bzeiss/roland-mram-card/mram-card/d50mram.kicad_pcb

## KiCad design mram-card/d50mram.kicad_pcb (2024-01-06)

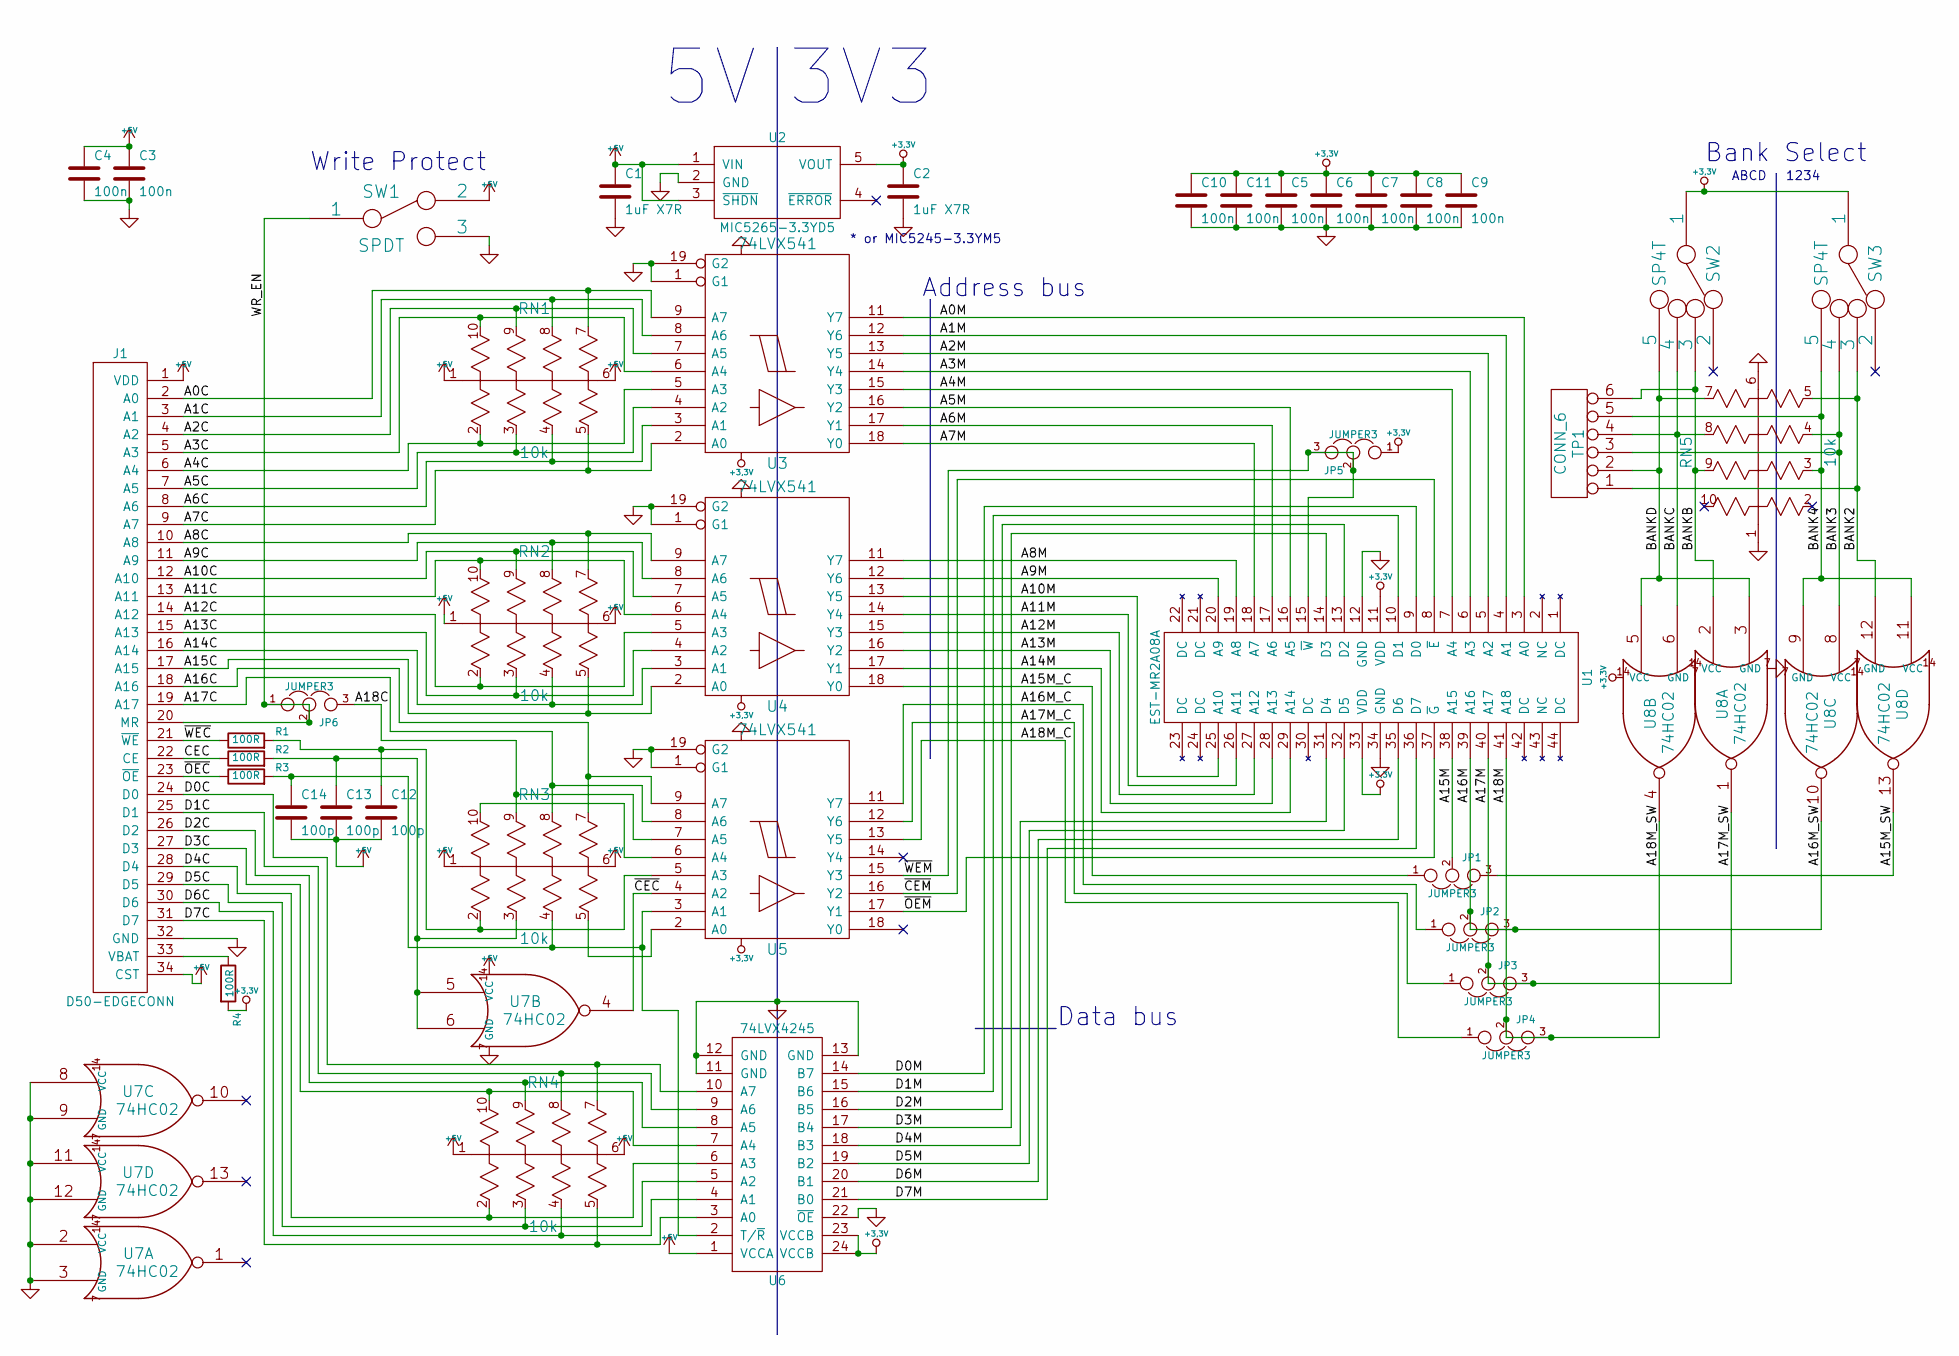
[picture p1: schematic d50mram.kicad_sch]

Parts:
C1, C2: 1uF X7R; C_0603_1608Metric
C3, C4, C5, C6, C7, C8, C9, C10, C11: 100n; C_0603_1608Metric
C12, C13, C14: 100p; C_0603_1608Metric
J1: D50-EDGECONN; EDGE1S34
JP1, JP2, JP3, JP4, JP5, JP6: JUMPER3; S_JUMPER_3
R1, R2, R3, R4: 100R; R_0603_1608Metric
RN1, RN2, RN3, RN4, RN5: 10k; CAT25; Digikey U8103CT-ND
SW1: SPDT; CUS-12B; Digikey 563-1102-1-ND
SW2, SW3: SP4T; CUS-14B; Digikey 563-1104-1-ND
TP1: CONN_6; 6P_TESTPT
U1: EST-MR2A08A; TSOP2-44; Digikey 819-1004-ND
U2: MIC5265-3.3YD5; SOT23-5; Digikey 576-2835-1-ND
U3, U4, U5: 74LVX541; tssop-20; Digikey 74LVX541MTCXCT-ND
U6: 74LVX4245; tssop-24; Digikey 74LVX4245MTCXCT-ND
U7, U8: 74HC02; tssop-14; Digikey MM74HC02MTCXCT-ND

Connections:
+3.3V: C2.1, C5.1, C6.1, C7.1, C8.1, C9.1, C10.1, C11.1, JP5.1, R4.2, SW2.1, SW3.1, U1.11 (VDD), U1.33 (VDD), U2.5 (VOUT), U3.20 (VCC), U4.20 (VCC), U5.20 (VCC), U6.23 (VCCB), U6.24 (VCCB), U8.14 (VCC)
+5V: C1.1, C3.1, C4.1, C12.2, C13.2, C14.2, J1.1 (VDD), J1.34 (CST), RN1.1, RN1.6, RN2.1, RN2.6, RN3.1, RN3.6, RN4.1, RN4.6, SW1.2, U2.1 (VIN), U2.3 (~SHDN), U6.1 (VCCA), U7.14 (VCC)
/A0C: J1.2 (A0), RN1.7, U3.9 (A7)
/A0M: U1.3 (A0), U3.11 (Y7)
/A1C: J1.3 (A1), RN1.8, U3.8 (A6)
/A1M: U1.4 (A1), U3.12 (Y6)
/A2C: J1.4 (A2), RN1.9, U3.7 (A5)
/A2M: U1.5 (A2), U3.13 (Y5)
/A3C: J1.5 (A3), RN1.10, U3.6 (A4)
/A3M: U1.6 (A3), U3.14 (Y4)
/A4C: J1.6 (A4), RN1.2, U3.5 (A3)
/A4M: U1.7 (A4), U3.15 (Y3)
/A5C: J1.7 (A5), RN1.3, U3.4 (A2)
/A5M: U1.16 (A5), U3.16 (Y2)
/A6C: J1.8 (A6), RN1.4, U3.3 (A1)
/A6M: U1.17 (A6), U3.17 (Y1)
/A7C: J1.9 (A7), RN1.5, U3.2 (A0)
/A7M: U1.18 (A7), U3.18 (Y0)
/A8C: J1.10 (A8), RN2.7, U4.9 (A7)
/A8M: U1.19 (A8), U4.11 (Y7)
/A9C: J1.11 (A9), RN2.8, U4.8 (A6)
/A9M: U1.20 (A9), U4.12 (Y6)
/A10C: J1.12 (A10), RN2.9, U4.7 (A5)
/A10M: U1.25 (A10), U4.13 (Y5)
/A11C: J1.13 (A11), RN2.10, U4.6 (A4)
/A11M: U1.26 (A11), U4.14 (Y4)
/A12C: J1.14 (A12), RN2.2, U4.5 (A3)
/A12M: U1.27 (A12), U4.15 (Y3)
/A13C: J1.15 (A13), RN2.3, U4.4 (A2)
/A13M: U1.28 (A13), U4.16 (Y2)
/A14C: J1.16 (A14), RN2.4, U4.3 (A1)
/A14M: U1.29 (A14), U4.17 (Y1)
/A15C: J1.17 (A15), RN2.5, U4.2 (A0)
/A15M: JP1.2, U1.38 (A15)
/A15M_C: JP1.1, U4.18 (Y0)
/A15M_SW: JP1.3, U8.13
/A16C: J1.18 (A16), RN3.7, U5.9 (A7)
/A16M: JP2.2, JP2.3, U1.39 (A16), U8.10
/A16M_C: JP2.1, U5.11 (Y7)
/A17C: J1.19 (A17), RN3.8, U5.8 (A6)
/A17M: JP3.2, JP3.3, U1.40 (A17), U8.1
/A17M_C: JP3.1, U5.12 (Y6)
/A18C: JP6.3, RN3.9, U5.7 (A5)
/A18M: JP4.2, JP4.3, U1.41 (A18), U8.4
/A18M_C: JP4.1, U5.13 (Y5)
/BANK2: RN5.5, SW3.3, TP1.1, U8.12
/BANK3: RN5.4, SW3.4, TP1.3, U8.8
/BANK4: RN5.3, SW3.5, TP1.5, U8.9, U8.11
/BANKB: RN5.9, SW2.3, TP1.6, U8.2
/BANKC: RN5.8, SW2.4, TP1.4, U8.6
/BANKD: RN5.7, SW2.5, TP1.2, U8.3, U8.5
/CEC: J1.22 (CE), R2.1
/D0C: J1.24 (D0), RN4.7, U6.10 (A7)
/D0M: U1.9 (D0), U6.14 (B7)
/D1C: J1.25 (D1), RN4.8, U6.9 (A6)
/D1M: U1.10 (D1), U6.15 (B6)
/D2C: J1.26 (D2), RN4.9, U6.8 (A5)
/D2M: U1.13 (D2), U6.16 (B5)
/D3C: J1.27 (D3), RN4.10, U6.7 (A4)
/D3M: U1.14 (D3), U6.17 (B4)
/D4C: J1.28 (D4), RN4.2, U6.6 (A3)
/D4M: U1.31 (D4), U6.18 (B3)
/D5C: J1.29 (D5), RN4.3, U6.5 (A2)
/D5M: U1.32 (D5), U6.19 (B2)
/D6C: J1.30 (D6), RN4.4, U6.4 (A1)
/D6M: U1.35 (D6), U6.20 (B1)
/D7C: J1.31 (D7), RN4.5, U6.3 (A0)
/D7M: U1.36 (D7), U6.21 (B0)
/WR_EN: J1.20 (MR), JP6.1, JP6.2, SW1.1
/~CEC: U5.4 (A2), U7.4
/~CEM: U1.8 (~E), U5.16 (Y2)
/~OEC: J1.23 (~OE), R3.1
/~OEM: U1.37 (~G), U5.17 (Y1)
/~WEC: J1.21 (~WE), R1.1
/~WEM: JP5.2, JP5.3, U1.15 (~W), U5.15 (Y3)
GND: C1.2, C2.2, C3.2, C4.2, C5.2, C6.2, C7.2, C8.2, C9.2, C10.2, C11.2, J1.32 (GND), RN5.1, RN5.6, SW1.3, U1.12 (GND), U1.34 (GND), U2.2 (GND), U3.1 (G1), U3.10 (GND), U3.19 (G2), U4.1 (G1), U4.10 (GND), U4.19 (G2), U5.1 (G1), U5.10 (GND), U5.19 (G2), U6.11 (GND), U6.12 (GND), U6.13 (GND), U6.22 (~OE), U7.2, U7.3, U7.7 (GND), U7.8, U7.9, U7.11, U7.12, U8.7 (GND)
unnamed: C12.1, R1.2, RN3.2, U5.5 (A3)
unnamed: C13.1, R2.2, RN3.3, U7.5, U7.6
unnamed: C14.1, R3.2, RN3.4, U5.3 (A1), U6.2 (T/~R)
unnamed: J1.33 (VBAT), R4.1
unnamed: RN3.5, U5.2 (A0)
unnamed: RN3.10, U5.6 (A4)

Notes on the sheet:
Bank Select
Address bus
1234
ABCD
Data bus
Write Protect
3V3
* or MIC5245-3.3YM5

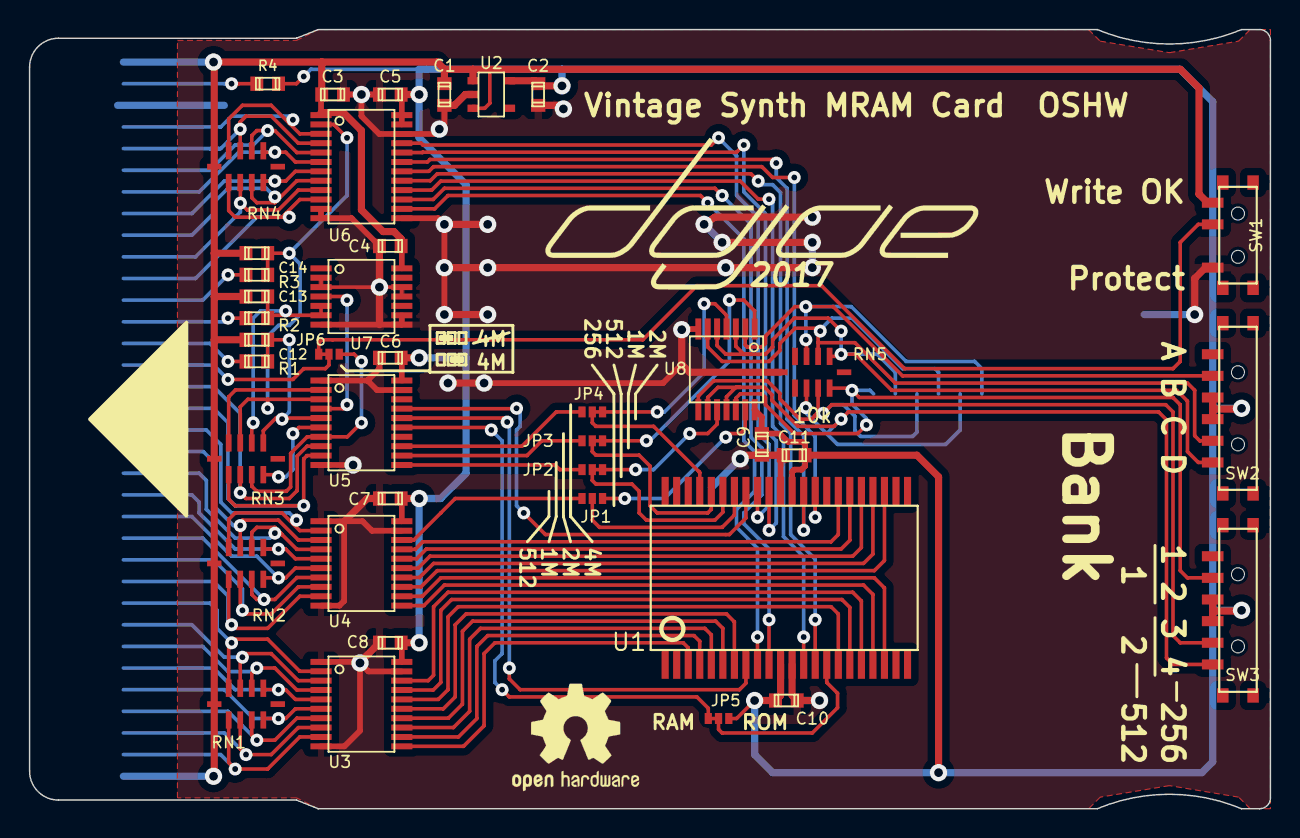
[picture p2: board d50mram.kicad_pcb from above]

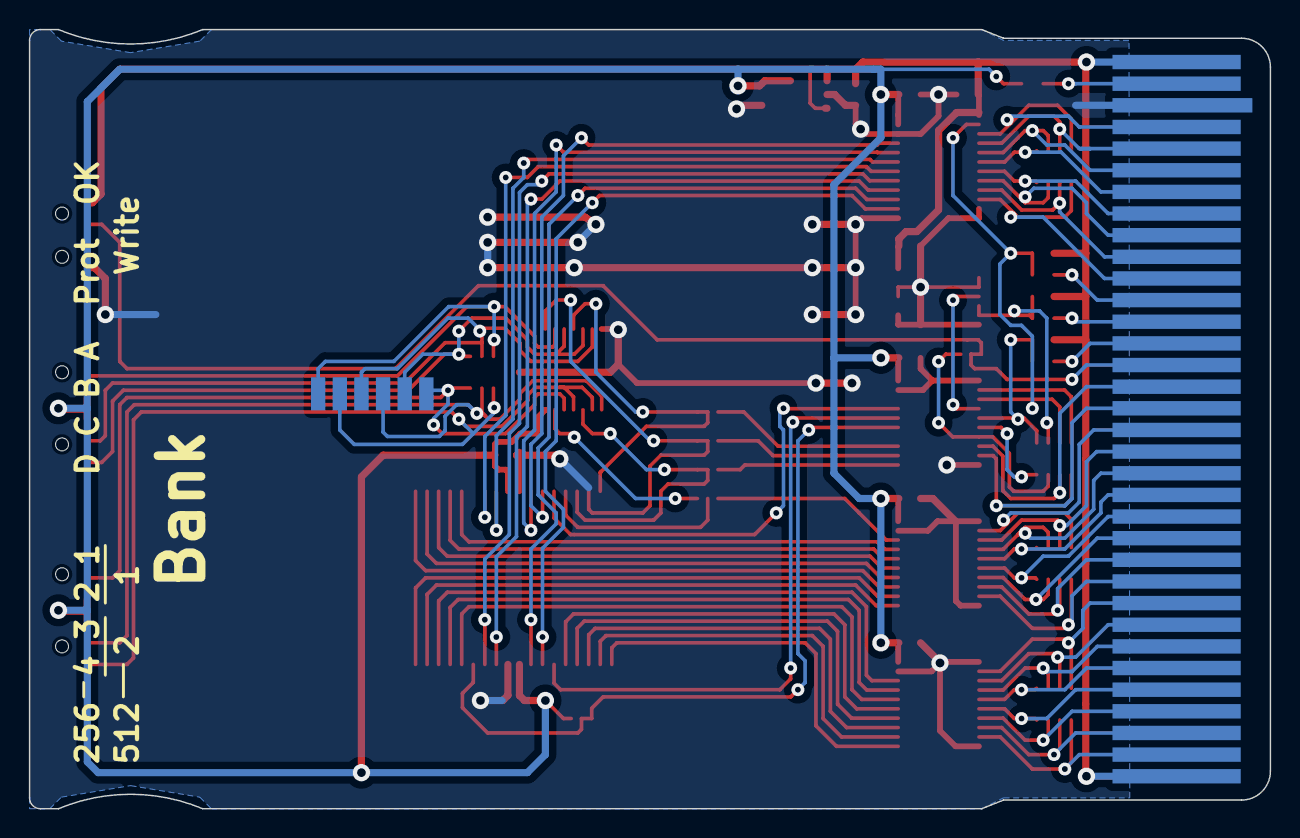
[picture p3: board d50mram.kicad_pcb from below]

Board: 2 copper layers, 86.0 x 54.0 mm, 43 parts (2 on the bottom side), 82 nets.

Other parts of the board:
VAL: REF; dojoe
