bzeiss/roland-mram-card/(commit log)

2024-01-06 Updates for Kicad 7, removed the gerber zip as the production files will move into the production directory from the fabrication toolkit.
    [d50mram.kicad_pcb]
2024-01-13 extracted the footprints from pcb file and reassigned the footprint mapping.
    [d50mram.kicad_sch]
